GEORGEAVRSAM/th4/work/prog.asm

; Μετρητής στη θύρα εξόδου: 0, 1, 2 ... 15, 0, 1 ...  με καθυστέρηση
        LOAD 0
loop:   OUT             ; γράψε τον A στη θύρα εξόδου
        LDB 15          ; καθυστέρηση: ο B μετράει 15 -> 0
wait:   DECB
        JNZ wait
        ADD 1           ; επόμενο νούμερο
        JUMP loop
